badassRavi/Hexapod-Robot/v2_hexapod_via_jp/v2_hexapod_via_jp.ino

#define S_RXD 18
#define S_TXD 19

#include <SCServo.h>
#include <algorithm>
#include <math.h>
SCSCL sc;

const float t(120.0), m(102.5), _2tm(24600.0), t2(14400.0), m2(10506.25), _2m(205.0), z_comp(26.2), y_comp(52.2), pi(3.14159265);
const int endpoint_low[6][4] = { { 250, 110, 15, 900 },
                                 { 230, 105, 60, 880 },
                                 { 240, 85, 70, 890 },
                                 { 215, 45, 30, 930 },
                                 { 240, 70, 50, 910 },
                                 { 275, 85, 60, 890 } };
const int endpoint_high[6][4] = { { 900, 970, 875, 40 },
                                  { 880, 965, 920, 20 },
                                  { 890, 945, 935, 30 },
                                  { 865, 905, 890, 70 },
                                  { 890, 930, 910, 50 },
                                  { 925, 945, 920, 30 } };

const float off_set[6] = { -60., 0.0, 60.0, 120.0, 180.0, -120.0 };
float bz_pts[3][11][3];
float lin_pts[3][11][3];
int loc(0), max_trajec_pts, move, max_disp;
float lambda, theta, beta, gama, delta, last_ang, curr_ang, gen_speed=400;
unsigned long ti, tf;

struct coordinate{
  float x,y,z;
  coordinate()
  {

  }
  coordinate(float _x, float _y , float _z)
  {
    x = _x;
    y = _y;
    z = _z;
  }
};

class LEG {
public:
  int id, pos[4], s_id[4], speed[4]={500,500,500,500};
  float x, y, z;
  LEG(int ID) 
  {
    id = ID;
    for (int i = 0; i < 4; i++) 
    {
      s_id[i] = (4 * id) + i + 1;
      pos[i] = sc.ReadPos(s_id[i]);
      delay(10);
    }
  }

  void joint(int S_ID, int POS) 
  {
    pos[S_ID] = POS;
    sc.WritePos(s_id[S_ID], POS, 0, speed[S_ID]);
  }
  void joint(int S_ID, int POS, int speed) 
  {
    pos[S_ID] = POS;
    sc.WritePos(s_id[S_ID], POS, 0, speed);
  }

  void go_to(float X, float Y, float Z);

  int load(int i)  //-1<i<4
  {
    return sc.ReadLoad(s_id[i]);
  }
};

LEG* set[6];

// void print() {
//   for (int i = 0; i <= 0; i++) {
//     for (int j = 1; j <= 4; j++) {
//       Serial.print(" Servo ID : ");
//       Serial.print(i + j);
//       Serial.print(" Pos : ");
//       Serial.print(pos[i][i + j]);
//       Serial.print("\n");
//     }
//   }
// }

float todeg(float rad) {
  return (rad / pi) * 180.0;
}

void print_ang(int leg) {
  Serial.print(leg);
  Serial.print(" Theta : ");
  Serial.print(todeg(theta));
  Serial.print(" Lambda : ");
  Serial.print(todeg(lambda));
  Serial.print(" Beta : ");
  Serial.print(todeg(beta));
  Serial.print(" Gamma : ");
  Serial.print(todeg(gama));
  Serial.print(" Delta : ");
  Serial.print(todeg(delta));
  Serial.print(set[leg]->speed[0]);
  Serial.print(" ");
  Serial.print(set[leg]->speed[1]);
  Serial.print(" ");
  Serial.print(set[leg]->speed[2]);
  Serial.print(" ");
  Serial.print(set[leg]->speed[3]);
  Serial.print(" ");
  Serial.print(" Time taken (us) : ");
  Serial.print(tf - ti);
  Serial.print("\n");
}

bool maximum(float a, float b)
{
  return a<b;
}

void set_speed(int pos0, int pos1, int pos2, int pos3, int leg)
{
  LEG* l=set[leg];
  Serial.print(pos1);
  Serial.print("\n");
  float del0,del1,del2,del3;
  del0 = float(abs(l->pos[0] - pos0));
  del1 = float(abs(l->pos[1] - pos1));
  del2 = float(abs(l->pos[2] - pos2));
  del3 =  float(abs(l->pos[3] - pos3));
  float max_del = max({del0,del1,del2,del3},maximum);
  max_disp = max_del;
  l->speed[0] = int(gen_speed*(del0/max_del));
  l->speed[1] = int(gen_speed*(del1/max_del));
  l->speed[2] = int(gen_speed*(del2/max_del));
  l->speed[3] = int(gen_speed*(del3/max_del));
}
void ik(int leg) {
  ti = micros();
  float temp1 = (sqrt((set[leg]->x * set[leg]->x) + (set[leg]->y * set[leg]->y)) - y_comp);
  float temp2 = (z_comp - set[leg]->z);
  float r = sqrt(temp2 * temp2 + temp1 * temp1);
  if (r >= 222.5) return;
  float r2 = r * r;
  //calculating theta
  theta = asin((z_comp - set[leg]->z) / r);

  //calculating lambda
  if (set[leg]->x)  //for non zero values of x
  {
    lambda = atan(set[leg]->y / set[leg]->x);
    if (lambda < 0) {
      lambda = pi + lambda;
    }
  } else {
    lambda = pi / 2.0;
  }
  // Serial.print(lambda);
  // Serial.print(" ");
  if (lambda < 0 || lambda > pi) return;  //this is to prevent any bizzare movement which may result in something breaking.

  //calculating beta
  beta = acos((t2 + m2 - r2) / _2tm);
  // Serial.print(beta);
  // Serial.print(" ");
  if (beta < 0.5890485 || beta > pi) return;  //this is to prevent any bizzare movement which may result in something breaking.

  //calculating gamma
  gama = acos((m2 + r2 - t2) / (_2m * r));

  //calculating delta
  delta = (pi / 2.0) + theta - gama;
  // Serial.print(delta);
  // Serial.print(" ");
  if (delta < 0 || delta > pi) return;  //this is to prevent any bizzare movement which may result in something breaking.
  tf = micros();
  int pos0 = map(todeg(beta), 33.75, 180, endpoint_low[leg][0], endpoint_high[leg][0]);
  int pos1 = map(90, 0, 180, endpoint_low[leg][1], endpoint_high[leg][1]);
  int pos2 = map(todeg(delta), 0, 180, endpoint_low[leg][2], endpoint_high[leg][2]);
  int pos3 = map(todeg(lambda), 0, 180, endpoint_low[leg][3], endpoint_high[leg][3]);
  //sc.WritePos(id[leg][0], pos[leg][0], 0, 100);
  set_speed(pos0,pos1,pos2,pos3,leg);

  set[leg]->joint(0,pos0);
  //delay(10);
  set[leg]->joint(1,pos1);
  //delay(10);
  //sc.WritePos(id[leg][2], pos[leg][2], 0, 100);
  set[leg]->joint(2,pos2);
  //delay(10);
  //sc.WritePos(id[leg][3], pos[leg][3], 0, 100);
  set[leg]->joint(3,pos3);
  //delay(10);
  print_ang(leg);
}

void LEG::go_to(float X, float Y, float Z)
  {
    x=X;
    y=Y;
    z=Z;
    ik(id);
  }

void generate_trajec(float deg, float height) {
  float m_slope = tan((deg / 180) * pi);
  float m_slope_2 = m_slope * m_slope;
  float m_disp = ((100 * (1 + m_slope_2)) / (1 + (16 * m_slope_2)));
  float f_slope = tan((deg + 60 / 180) * pi);
  float f_slope_2 = f_slope * f_slope;
  float f_disp = ((100 * (1 + f_slope_2)) / (1 + (16 * f_slope_2)));
  float b_slope = tan((deg - 60 / 180) * pi);
  float b_slope_2 = b_slope * b_slope;
  float b_disp = ((100 * (1 + b_slope_2)) / (1 + (16 * b_slope_2)));
  float disp = min({ m_disp, f_disp, b_disp });
  coordinate bz_limit_pt[3][2];
  for(int i=0;i<3;i++)
  {
      bz_limit_pt[i][0].x = disp*cos(deg+((1-i)*60));
      bz_limit_pt[i][0].y = disp*sin(deg+((1-i)*60));
      bz_limit_pt[i][0].z = height;
      bz_limit_pt[i][1].x = bz_limit_pt[i][0].x/2;
      bz_limit_pt[i][1].y = bz_limit_pt[i][0].y/2;
      bz_limit_pt[i][1].z = -height/2;
      bz_limit_pt[i][2].x = -bz_limit_pt[i][0].x/2;
      bz_limit_pt[i][2].y = -bz_limit_pt[i][0].y/2;
      bz_limit_pt[i][2].z = -height/2;
      bz_limit_pt[i][3].x = - bz_limit_pt[i][0].x;
      bz_limit_pt[i][3].y = - bz_limit_pt[i][0].y;
      bz_limit_pt[i][3].z = height;
      gen_bz_pts(bz_limit_pt[i][0],bz_limit_pt[i][0],bz_limit_pt[i][0],bz_limit_pt[i][0],10,i);
  }
  
  
}

void boot_seq() {
  for (int i = 0; i < 6; i++) {
    set[i]->go_to(0.0, 180.0,-100.0);
  }
}

void gen_bz_pts(coordinate start_pt, coordinate p1_pt, coordinate p2_pt, coordinate end_pt, int num_points, int leg_id)
{
  float deltax = float(start_pt.x-end_pt.x)/(num_points+1), lin_x = end_pt.x;
  float deltay = float(end_pt.y-start_pt.y)/(num_points+1),lin_y = end_pt.y;
  for (int t = 0; t < num_points+1 ; ++t) {
        float t_normalized = static_cast<float>(t) / num_points;
        float y = start_pt.y + deltay*t;
        float x = (pow(1 - t_normalized, 3) * start_pt.x)
                   + (3 * pow(1 - t_normalized, 2) * t_normalized * p2_pt.x)
                   + (3 * (1 - t_normalized) * pow(t_normalized, 2) *p2_pt.x)
                   + pow(t_normalized, 3) * end_pt.x;
        float z = (pow(1 - t_normalized, 3) * start_pt.z)
                   + (3 * pow(1 - t_normalized, 2) * t_normalized * p1_pt.z)
                   + (3 * (1 - t_normalized) * pow(t_normalized, 2) * p2_pt.z)
                   + pow(t_normalized, 3) * end_pt.z;
        bz_pts[leg_id][t][0] = x;
        bz_pts[leg_id][t][1] = y;
        bz_pts[leg_id][t][2] = z;
        lin_x+=deltax;
        lin_y-=deltay;
        lin_pts[leg_id][t][0] = lin_x;
        lin_pts[leg_id][t][1] = start_pt.y;
        lin_pts[leg_id][t][2] = start_pt.z;
    }
    return;
}
void setup() {
  Serial1.begin(1000000, SERIAL_8N1, S_RXD, S_TXD);
  Serial.begin(115200);
  sc.pSerial = &Serial1;
  delay(1000);
  for (int i = 0; i < 6; i++) {
    LEG* place_holder = new LEG(i);
    set[i] = place_holder;
    set[i]->joint(1,int(endpoint_low[i][1] + 430));
    delay(10);
  }
  boot_seq();
  coordinate start_pt = coordinate (120.,120.,-100.);
  coordinate p1_pt = coordinate(50.,120.,30.);
  coordinate p2_pt = coordinate(-50.,120.,30.);
  coordinate end_pt = coordinate(-120.,80.,-100.);
  gen_bz_pts(start_pt,p1_pt,p2_pt,end_pt,10,0);
  Serial.print("\n");
  for(int k = 0; k<3;k++)
  {
    for(int j = 0; j<3 ; j++)
    {
      for(int i = 0; i<11; i++)
      {
        Serial.print(bz_pts[k][i][j]);
        Serial.print(" ");
      }
      Serial.print("\n");
    }
    Serial.println("");
  }
}


void loop() {
  int i = 0 ;
  if(Serial.available())
  {
    int deg = Serial.readStringUntil(' ').toInt();
    float z_ht = Serial.readStringUntil('\r').toFloat();
    generate_trajec(deg, z_ht);
  }
  while(i<11)
  {
    for(int j = 0; j<3;j++)
    {
      set[0]->go_to(bz_pts[j][i][0], bz_pts[j][i][1], bz_pts[j][i][2]);
      set[1]->go_to(bz_pts[j][i][0], bz_pts[j][i][1], bz_pts[j][i][2]);
      set[2]->go_to(bz_pts[j][i][0], bz_pts[j][i][1], bz_pts[j][i][2]);
      set[3]->go_to(bz_pts[j][i][0], bz_pts[j][i][1], bz_pts[j][i][2]);
      set[4]->go_to(bz_pts[j][i][0], bz_pts[j][i][1], bz_pts[j][i][2]);
      set[5]->go_to(bz_pts[j][i][0], bz_pts[j][i][1], bz_pts[j][i][2]);
      Serial.print("x= ");
      Serial.print(bz_pts[j][i][0]);
      Serial.print("y= ");
      Serial.print(bz_pts[j][i][1]);
      Serial.print("z= ");
      Serial.print(bz_pts[j][i][2]);
      Serial.print("\n");
      i++;
      delay(150);
    }
  }
  i=0;
  // set[0]->go_to(100,120,-100);
  // set[1]->go_to(100,120,-100);
  // set[2]->go_to(100,120,-100);
  // set[3]->go_to(100,120,-100);
  // set[4]->go_to(100,120,-100);
  // set[5]->go_to(100,120,-100);
  // delay(100);
while(i<11)
  {
    for(int  j = 0 ; j<3;j++)
    {
      set[0]->go_to(lin_pts[j][i][0], lin_pts[j][i][1], lin_pts[j][i][2]);
      set[1]->go_to(lin_pts[j][i][0], lin_pts[j][i][1], lin_pts[j][i][2]);
      set[2]->go_to(lin_pts[j][i][0], lin_pts[j][i][1], lin_pts[j][i][2]);
      set[3]->go_to(lin_pts[j][i][0], lin_pts[j][i][1], lin_pts[j][i][2]);
      set[4]->go_to(lin_pts[j][i][0], lin_pts[j][i][1], lin_pts[j][i][2]);
      set[5]->go_to(lin_pts[j][i][0], lin_pts[j][i][1], lin_pts[j][i][2]);
      Serial.print("linear");
      Serial.print("\n");
      i++;
      delay(150);
    }
  }
}
